Scott216/Poolduino/Board Files/Current_sensor.jpg

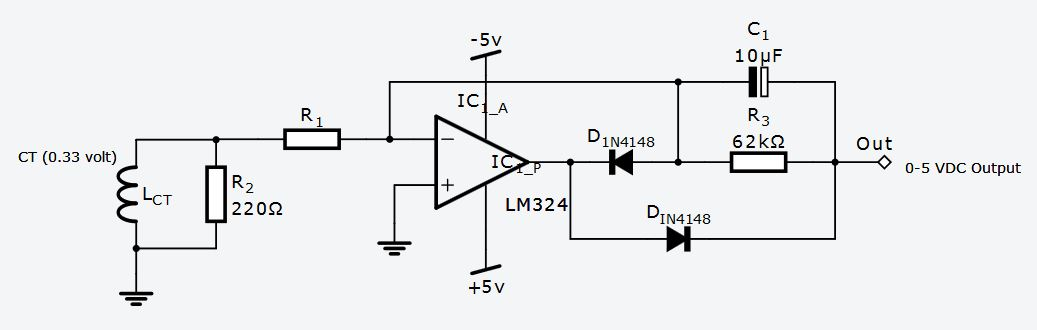
Board Files/Current_sensor.jpg
