Scott216/Poolduino/(threads)

Thread 2 (2015-03-03):

boards available

davecramer, 2015-03-03:
Sorry to use this forum for a question but it seems the only way

Have you produced boards ?

Scott216, 2015-03-05:
I made some PCB boards for myself, the files are located here:
https://github.com/Scott216/Poolduino/tree/master/Board%20Files

I don't have any plans to sell the PCB boards.

davecramer, 2015-03-05:
thx

Closed 2015-03-05.
