Scott216/Poolduino/Board Files/CT Amp.brd

## EAGLE design Board Files/CT Amp.brd (2016-04-02)

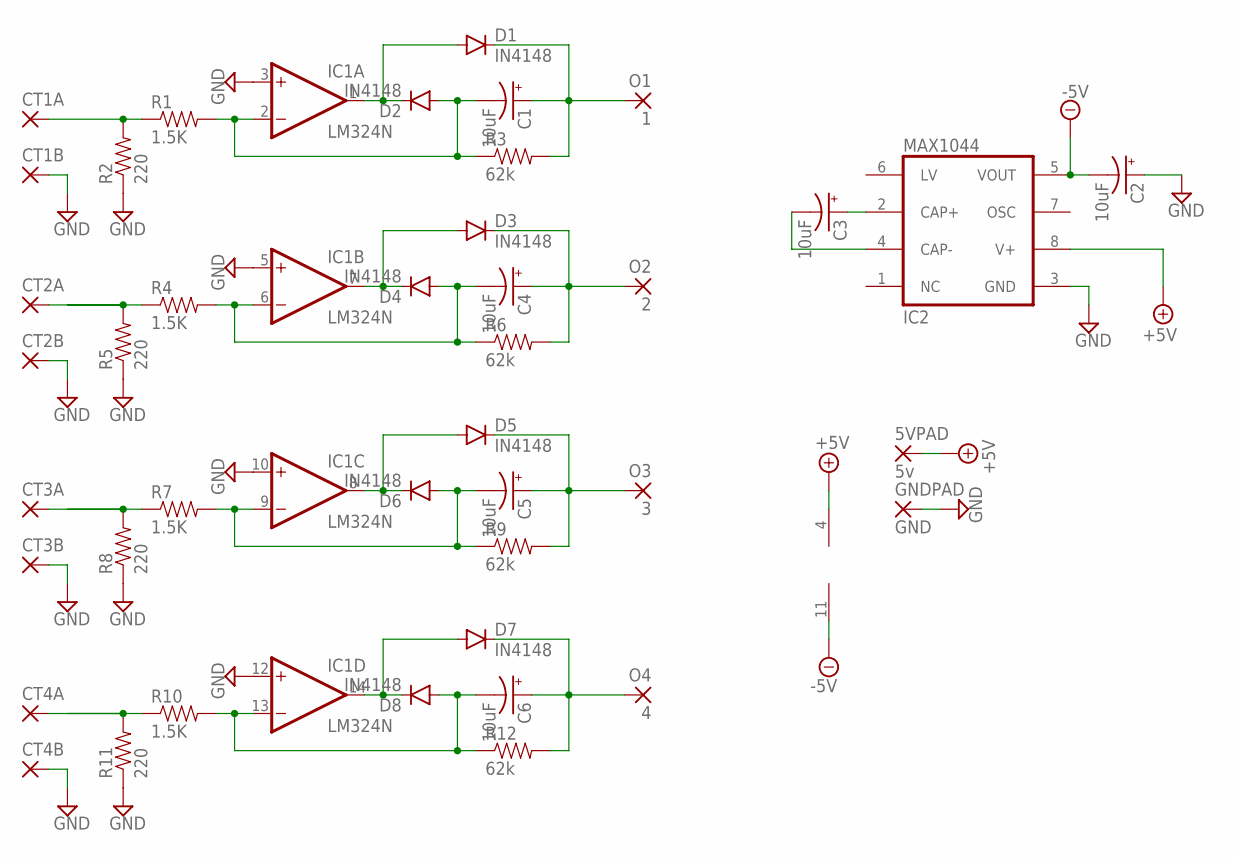
[picture p2: schematic CT Amp.sch]

Parts:
5VPAD: 5v; 2,54/1,0
C1, C2, C3, C4, C5, C6: 10uF; E2,5-6
CT1A, CT1B, CT2A, CT2B, CT3A, CT3B, CT4A, CT4B: 2,54/1,0
D1, D2, D3, D4, D5, D6, D7, D8: IN4148; DIODE-1N4001
GNDPAD: GND; 2,54/1,0
IC1: LM324N; DIL14
MAX1044: IC2; DIL08
O1: 1; 2,54/1,0
O2: 2; 2,54/1,0
O3: 3; 2,54/1,0
O4: 4; 2,54/1,0
R1, R4, R7, R10: 1.5K; AXIAL-0.4
R2, R5, R8, R11: 220; AXIAL-0.4
R3, R6, R9, R12: 62k; AXIAL-0.4

Connections:
+5V: 5VPAD.1, IC1.4 (V+), MAX1044.8 (V+)
-5V: C2.-, IC1.11 (V-), MAX1044.5 (VOUT)
GND: C2.+, CT1B.1, CT2B.1, CT3B.1, CT4B.1, GNDPAD.1, IC1.3 (+IN), IC1.5 (+IN), IC1.10 (+IN), IC1.12 (+IN), MAX1044.3 (GND), R2.P$1 (1), R5.P$1 (1), R8.P$1 (1), R11.P$1 (1)
unnamed: C3.+, MAX1044.2 (CAP+)
unnamed: C3.-, MAX1044.4 (CAP-)
unnamed: CT2A.1, R4.P$1 (1), R5.P$2 (2)
unnamed: C1.-, D2.A, IC1.2 (-IN), R1.P$2 (2), R3.P$1 (1)
unnamed: C5.-, D6.A, IC1.9 (-IN), R7.P$2 (2), R9.P$1 (1)
unnamed: CT3A.1, R7.P$1 (1), R8.P$2 (2)
unnamed: D1.A, D2.C, IC1.1 (OUT)
unnamed: D5.A, D6.C, IC1.8 (OUT)
unnamed: C5.+, D5.C, O3.1, R9.P$2 (2)
unnamed: C6.-, D8.A, IC1.13 (-IN), R10.P$2 (2), R12.P$1 (1)
unnamed: C4.-, D4.A, IC1.6 (-IN), R4.P$2 (2), R6.P$1 (1)
unnamed: D7.A, D8.C, IC1.14 (OUT)
unnamed: C6.+, D7.C, O4.1, R12.P$2 (2)
unnamed: C1.+, D1.C, O1.1, R3.P$2 (2)
unnamed: CT1A.1, R1.P$1 (1), R2.P$2 (2)
unnamed: CT4A.1, R10.P$1 (1), R11.P$2 (2)
unnamed: D3.A, D4.C, IC1.7 (OUT)
unnamed: C4.+, D3.C, O2.1, R6.P$2 (2)

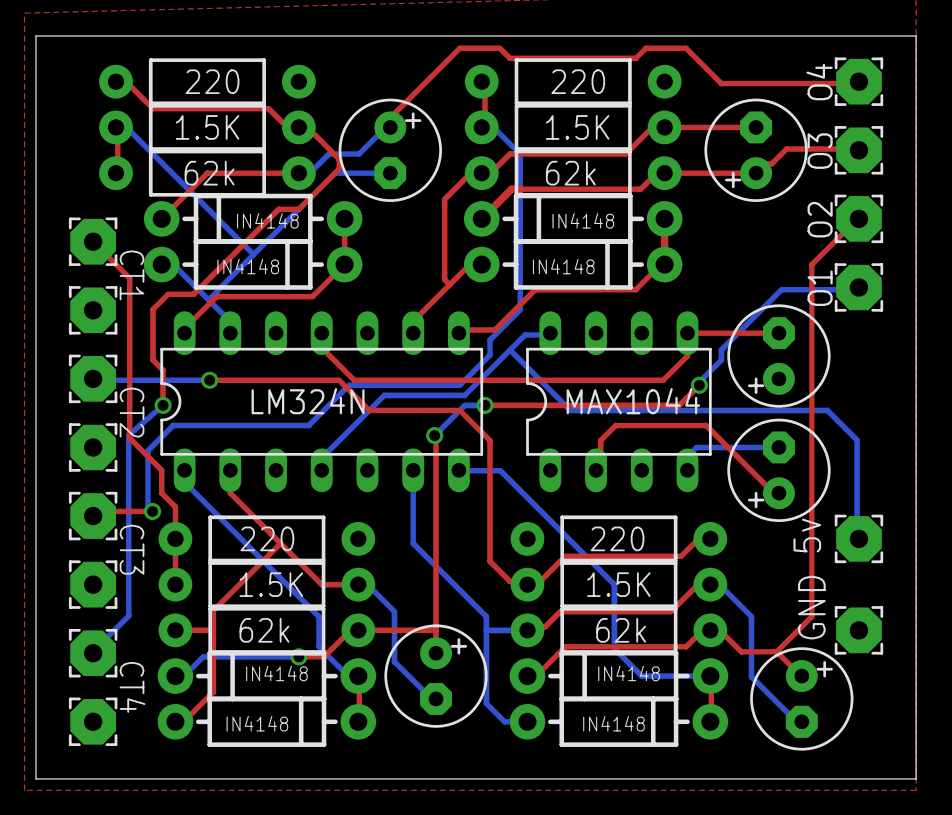
[picture p3: board CT Amp.brd from above]

Board: 2 copper layers, 48.9 x 41.3 mm, 42 parts (0 on the bottom side), 21 nets.
