Scott216/Poolduino/Board Files/Level Sensor v1.brd

## EAGLE design Board Files/Level Sensor v1.brd (2014-09-04)

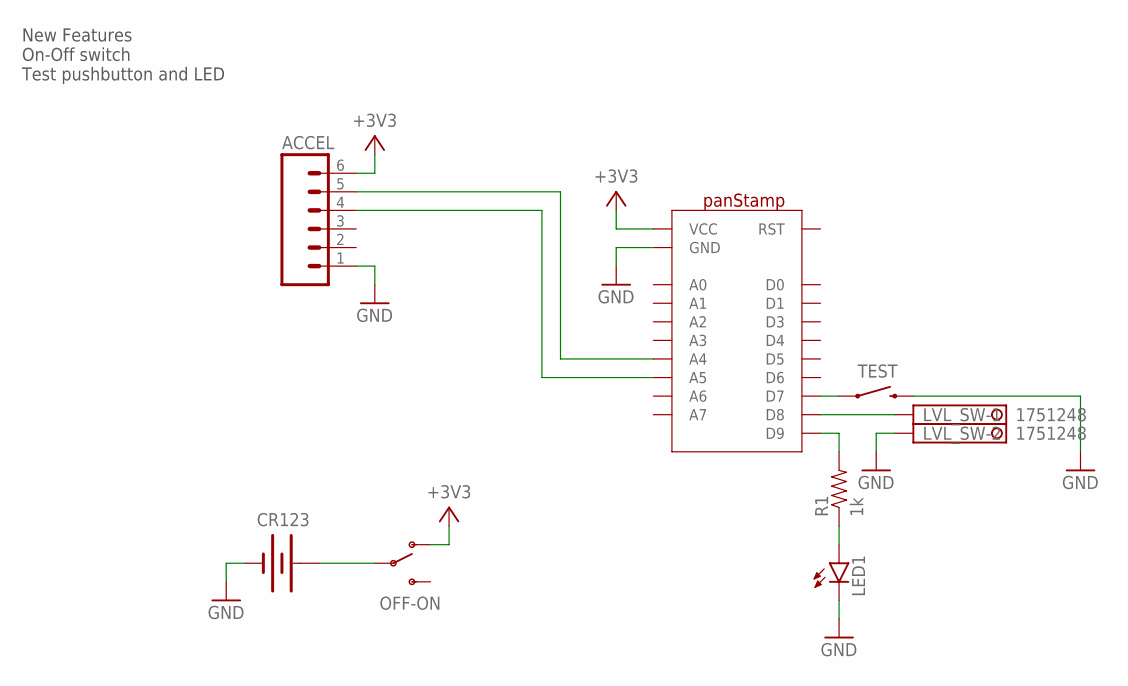
[picture p4: schematic Level Sensor v1.sch]

Parts:
ACCEL: M06LONGPADS; 1X06_LONGPADS
CR123: BATTERY_CR123_SINGLE; BATTERY_CR123
LED1: LED3MM
LVL_SW: 1751248
OFF-ON: SWITCH-SPDTPTH; SWITCH-SPDT
R1: 1k; AXIAL-0.4
TEST: SWITCH-MOMENTARY-2PTH; TACTILE-PTH
U$1: PANSTAMPWITH_TEXT; PANSTAMP

Connections:
+3V3: ACCEL.6, OFF-ON.1 (O), U$1.VCC
BAT+: CR123.POS (+), OFF-ON.2
GND: ACCEL.1, CR123.NEG (-), LED1.K (C), LVL_SW.2, TEST.3 (2), U$1.GND$1 (GND), U$1.GND$7 (GND), U$1.GND$15 (GND), U$1.GND$23 (GND), U$1.GND$24 (GND)
unnamed: LVL_SW.1, U$1.D8
unnamed: TEST.1, U$1.D7
unnamed: R1.P$2 (2), U$1.D9
unnamed: LED1.A, R1.P$1 (1)
SCL: ACCEL.4, U$1.A5
SDA: ACCEL.5, U$1.A4

Notes on the sheet:
New Features On-Off switch Test pushbutton and LED

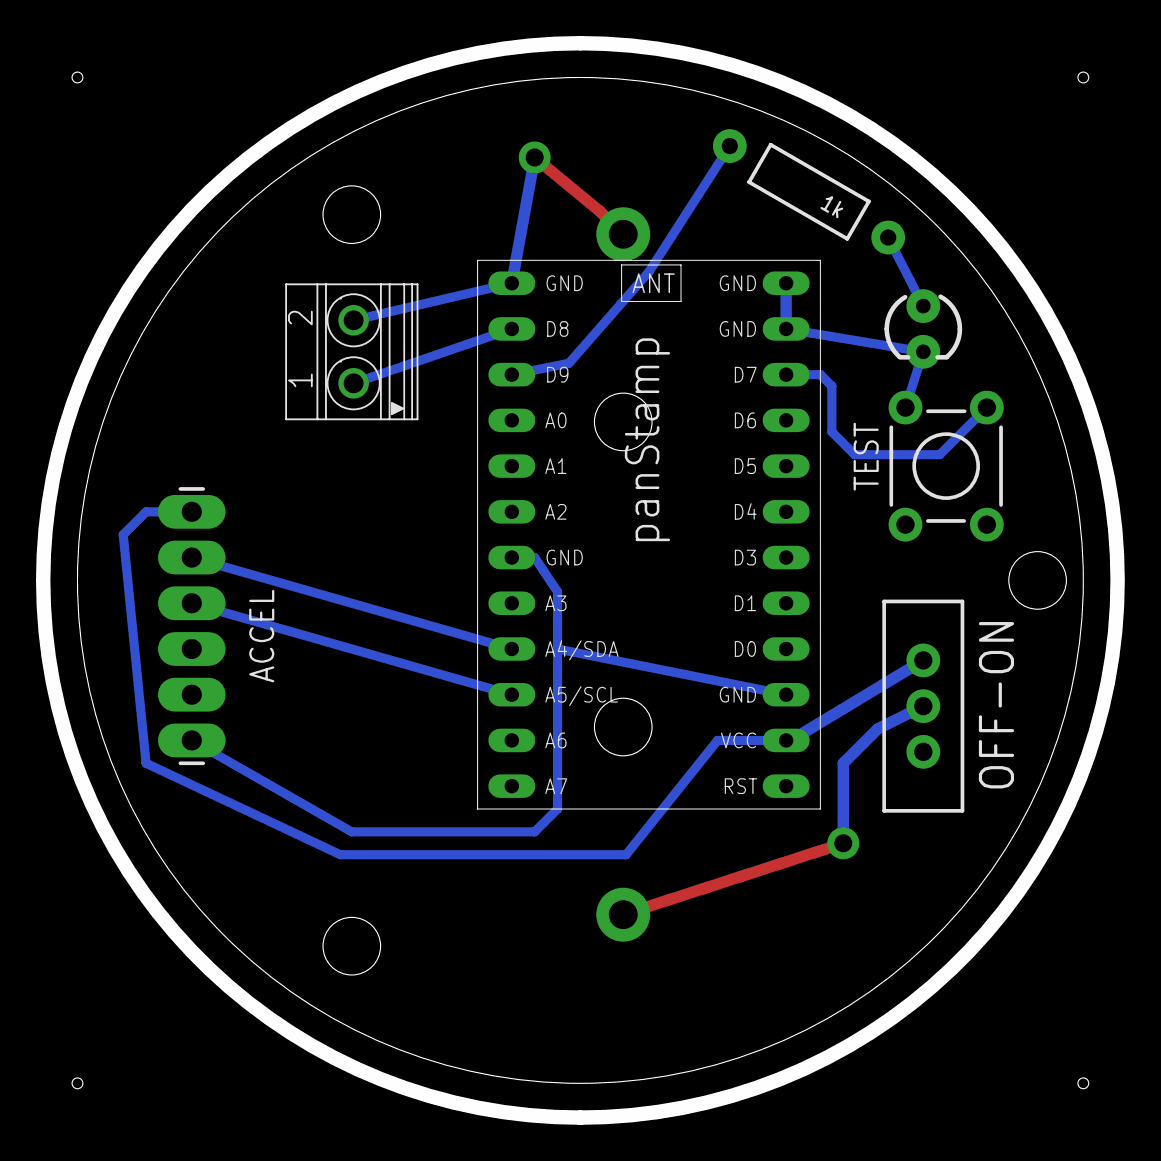
[picture p5: board Level Sensor v1.brd from above]

Board: 2 copper layers, 59.7 x 59.7 mm, 8 parts (1 on the bottom side), 9 nets.
