Scott216/Poolduino/Board Files/Xbee_Sheild_v2.brd

## EAGLE design Board Files/Xbee_Sheild_v2.brd (2014-09-04)

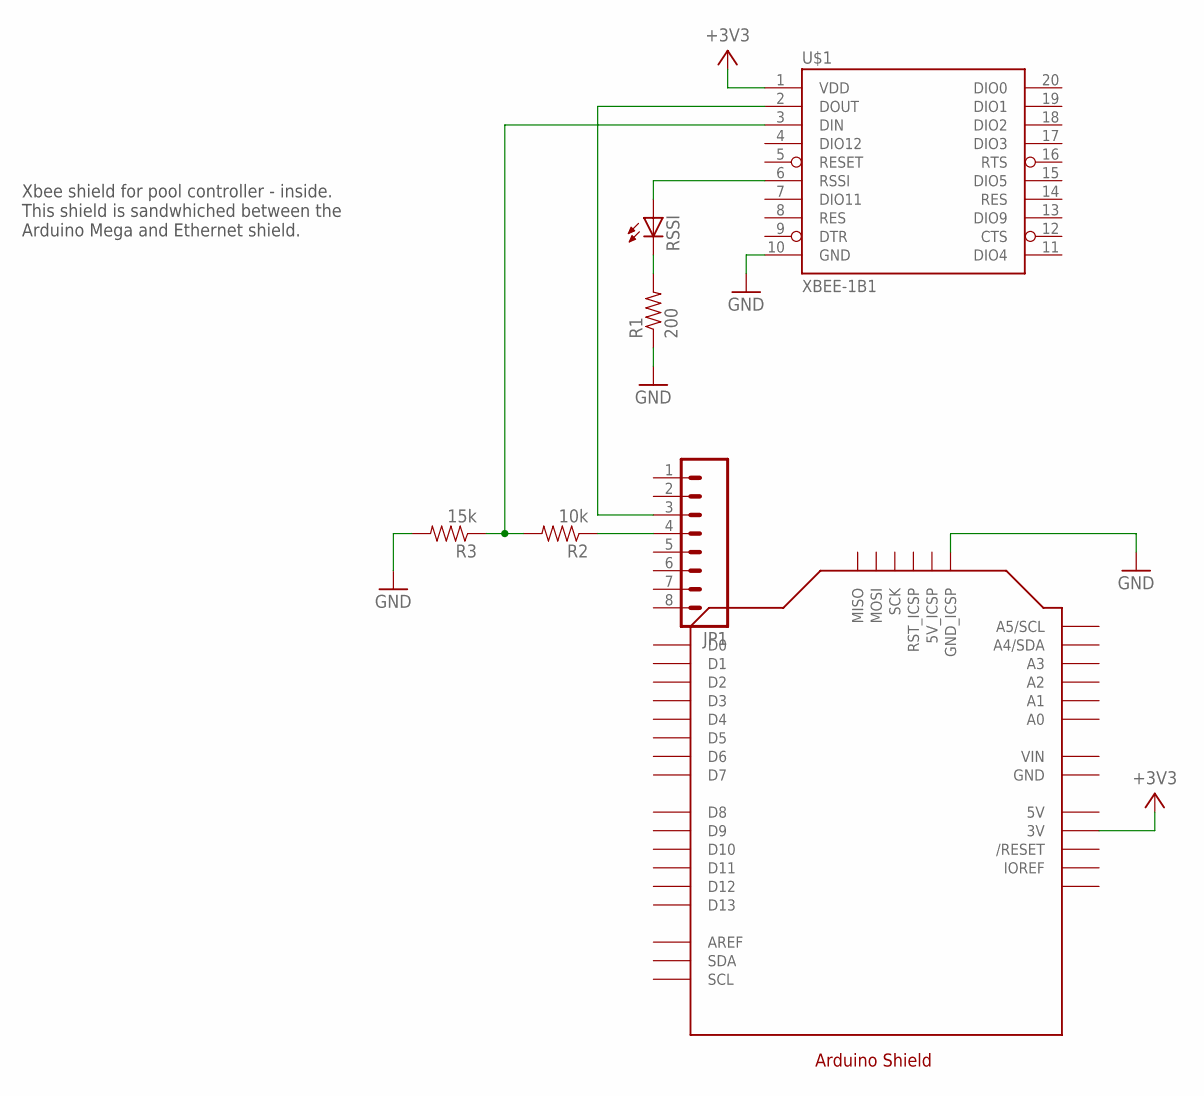
[picture p6: schematic Xbee_Sheild_v2.sch]

Parts:
JP1: M08LONGPADS; 1X08_LONGPADS
R1: 200; AXIAL-0.4
R2: 10k; AXIAL-0.4
R3: 15k; AXIAL-0.4
RSSI: LED5MM
U$1: XBEE-1B1; XBEE-1
U$2: ARDUINO_UNO_SHIELD_ICSP

Connections:
5V: U$2.5V@1 (5V)
5V_ICSP: U$2.5V_ICSP
+3V3: U$1.1 (VDD), U$2.3V
GND: R1.P$1 (1), R3.P$2 (2), U$1.10 (GND), U$2.GND@1 (GND), U$2.GND@2 (GND), U$2.GND@3 (GND), U$2.GND_ICSP
unnamed: JP1.3, U$1.2 (DOUT)
unnamed: JP1.4, R2.P$1 (1)
unnamed: RSSI.A, U$1.6 (RSSI)
unnamed: R1.P$2 (2), RSSI.K (C)
unnamed: R2.P$2 (2), R3.P$1 (1), U$1.3 (DIN)
VIN: U$2.VIN

Notes on the sheet:
Xbee shield for pool controller - inside. This shield is sandwhiched between the Arduino Mega and Ethernet shield.

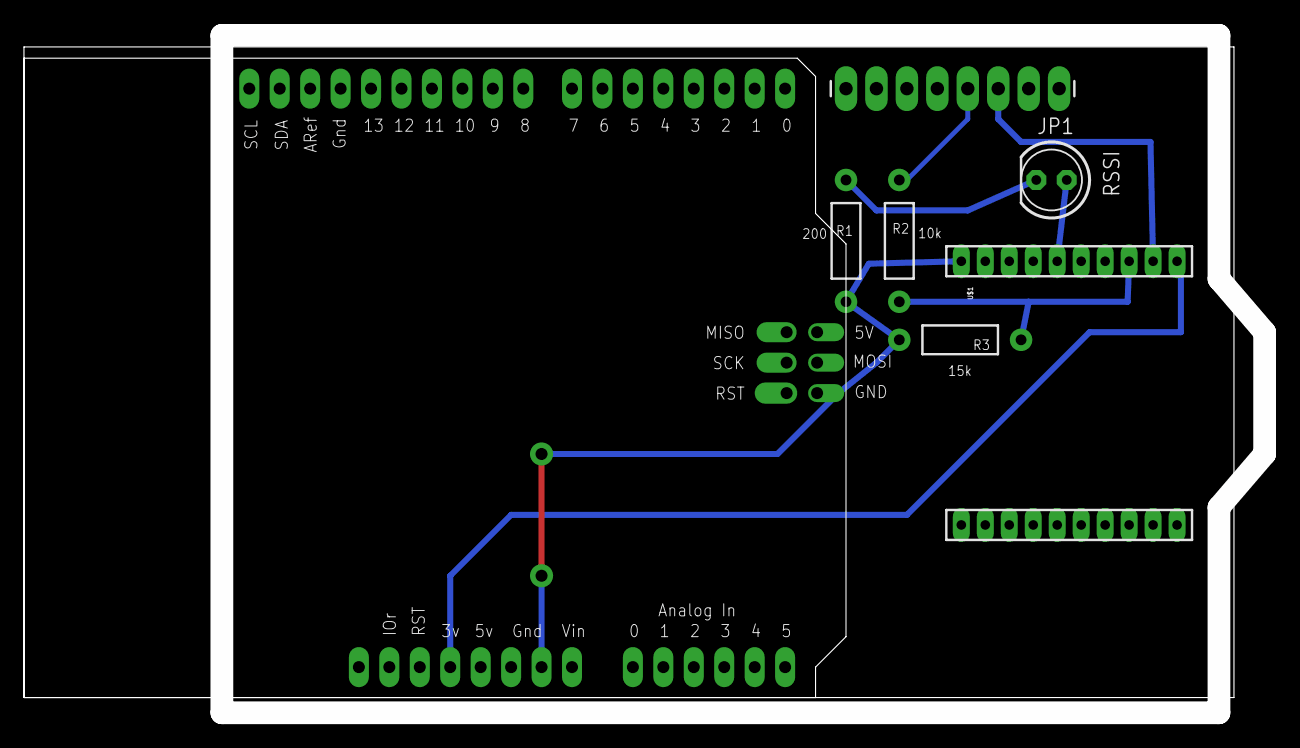
[picture p7: board Xbee_Sheild_v2.brd from above]

Board: 2 copper layers, 103.5 x 56.5 mm, 7 parts (0 on the bottom side), 7 nets.
