Scott216/Poolduino/Board Files/Outside Pool Controller v2.brd

## EAGLE design Board Files/Outside Pool Controller v2.brd (2014-09-04)

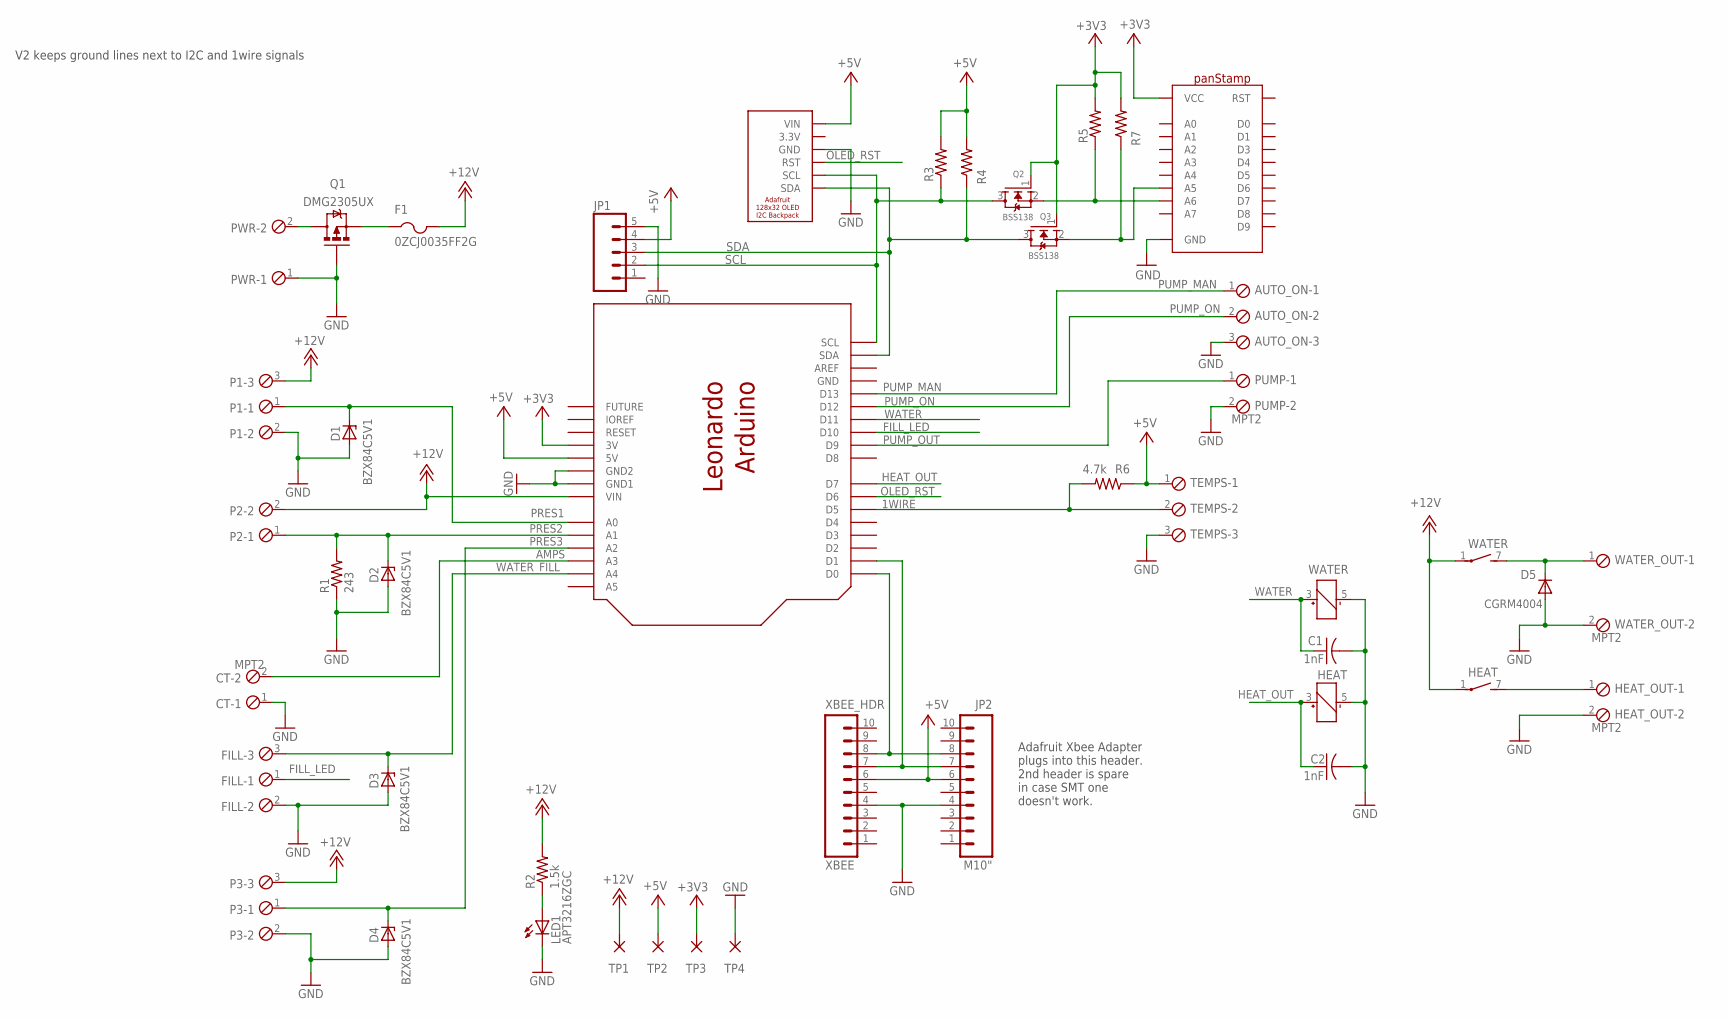
[picture p8: schematic Outside Pool Controller v2.sch]

Parts:
AUTO_ON: MPT3; 3POL254
C1, C2: 1nF; C1206
CT: MPT2; 2POL254
D1, D2, D3, D4: BZX84C5V1; SOT23
D5: CGRM4004; SOD-123FL
F1: 0ZCJ0035FF2G; R1206
FILL: MPT3; 3POL254
HEAT: REED
HEAT_OUT: MPT2; 2POL254
JP1: M05NO_SILK; 1X05_NO_SILK
JP2: M10"; 1X10
LED1: APT3216ZGC; CHIPLED_1206
P1, P3: MPT3; 3POL254
P2: MPT2; 2POL254
PUMP: MPT2; 2POL254
PWR: MPT2; 2POL254
Q1: DMG2305UX; SOT23-3
Q2, Q3: BSS138; SOT23
R1: 243; M1206
R2: 1.5k; M1206
R3, R4, R5, R7: R-US_M1206; M1206
R6: 4.7k; M1206
TEMPS: MPT3; 3POL254
TP1, TP2: 2,15/1,0
TP3, TP4: WIREPAD2,15/1,0; 2,15/1,0
U$1: ARDUINO_LEONARDO
U$2: ADAFRUIT_128X32_OLED; ADAFRUIT_OLED_128X32
U$3: PANSTAMPNO_TEXT; PANSTAMP_NOTEXT
WATER: REED
WATER_OUT: MPT2; 2POL254
XBEE_HDR: XBEE; 1X10_SMD_MALE

Connections:
1WIRE: R6.2, TEMPS.2, U$1.D5
3.3V: U$2.P$5 (3.3V)
+3V3: Q2.1 (G), Q3.1 (G), R5.2, R7.2, TP3.1, U$1.3V, U$3.VCC
+5V: JP1.4, JP2.6, R3.2, R4.2, R6.1, TEMPS.1, TP2.1, U$1.5V, U$2.P$6 (VIN), XBEE_HDR.6
+12V: F1.2, HEAT.1, P1.3, P2.2, P3.3, R2.2, TP1.1, U$1.VIN, WATER.1
AMPS: CT.2, U$1.A3
FILL_LED: FILL.1, U$1.D10
GND: AUTO_ON.3, C1.2, C2.2, CT.1, D1.1 (A), D2.1 (A), D3.1 (A), D4.1 (A), D5.A, FILL.2, HEAT.5 (-), HEAT_OUT.2, JP1.5, JP2.4, LED1.C, P1.2, P3.2, PUMP.2, PWR.1, Q1.1 (G), R1.1, TEMPS.3, TP4.1, U$1.GND, U$1.GND$2 (GND2), U$1.GND$3 (GND1), U$2.P$4 (GND), U$3.GND$1 (GND), U$3.GND$7 (GND), U$3.GND$15 (GND), U$3.GND$23 (GND), U$3.GND$24 (GND), WATER.5 (-), WATER_OUT.2, XBEE_HDR.4
HEAT_OUT: C2.1, HEAT.3 (+), U$1.D7
unnamed: D5.C, WATER.7 (S), WATER_OUT.1
unnamed: HEAT.7 (S), HEAT_OUT.1
unnamed: PWR.2, Q1.3 (D)
unnamed: LED1.A, R2.1
unnamed: F1.1, Q1.2 (S)
OLED_RST: U$1.D6, U$2.P$3 (RST)
PRES1: D1.3 (C), P1.1, U$1.A0
PRES2: D2.3 (C), P2.1, R1.2, U$1.A1
PRES3: D4.3 (C), P3.1, U$1.A2
PUMP_MAN: AUTO_ON.1, U$1.D13
PUMP_ON: AUTO_ON.2, U$1.D12
PUMP_OUT: PUMP.1, U$1.D9
SCL: JP1.2, Q2.3 (D), R3.1, U$1.SCL, U$2.P$2 (SCL)
SCL3.3: Q2.2 (S), R5.1, U$3.A6
SDA: JP1.3, Q3.3 (D), R4.1, U$1.SDA, U$2.P$1 (SDA)
SDA3.3: Q3.2 (S), R7.1, U$3.A5
WATER: C1.1, U$1.D11, WATER.3 (+)
WATER_FILL: D3.3 (C), FILL.3, U$1.A4
XBEE0: JP2.8, U$1.D0, XBEE_HDR.8
XBEE1: JP2.7, U$1.D1, XBEE_HDR.7

Notes on the sheet:
V2 keeps ground lines next to I2C and 1wire signals
Adafruit Xbee Adapter plugs into this header. 2nd header is spare in case SMT one doesn't work.

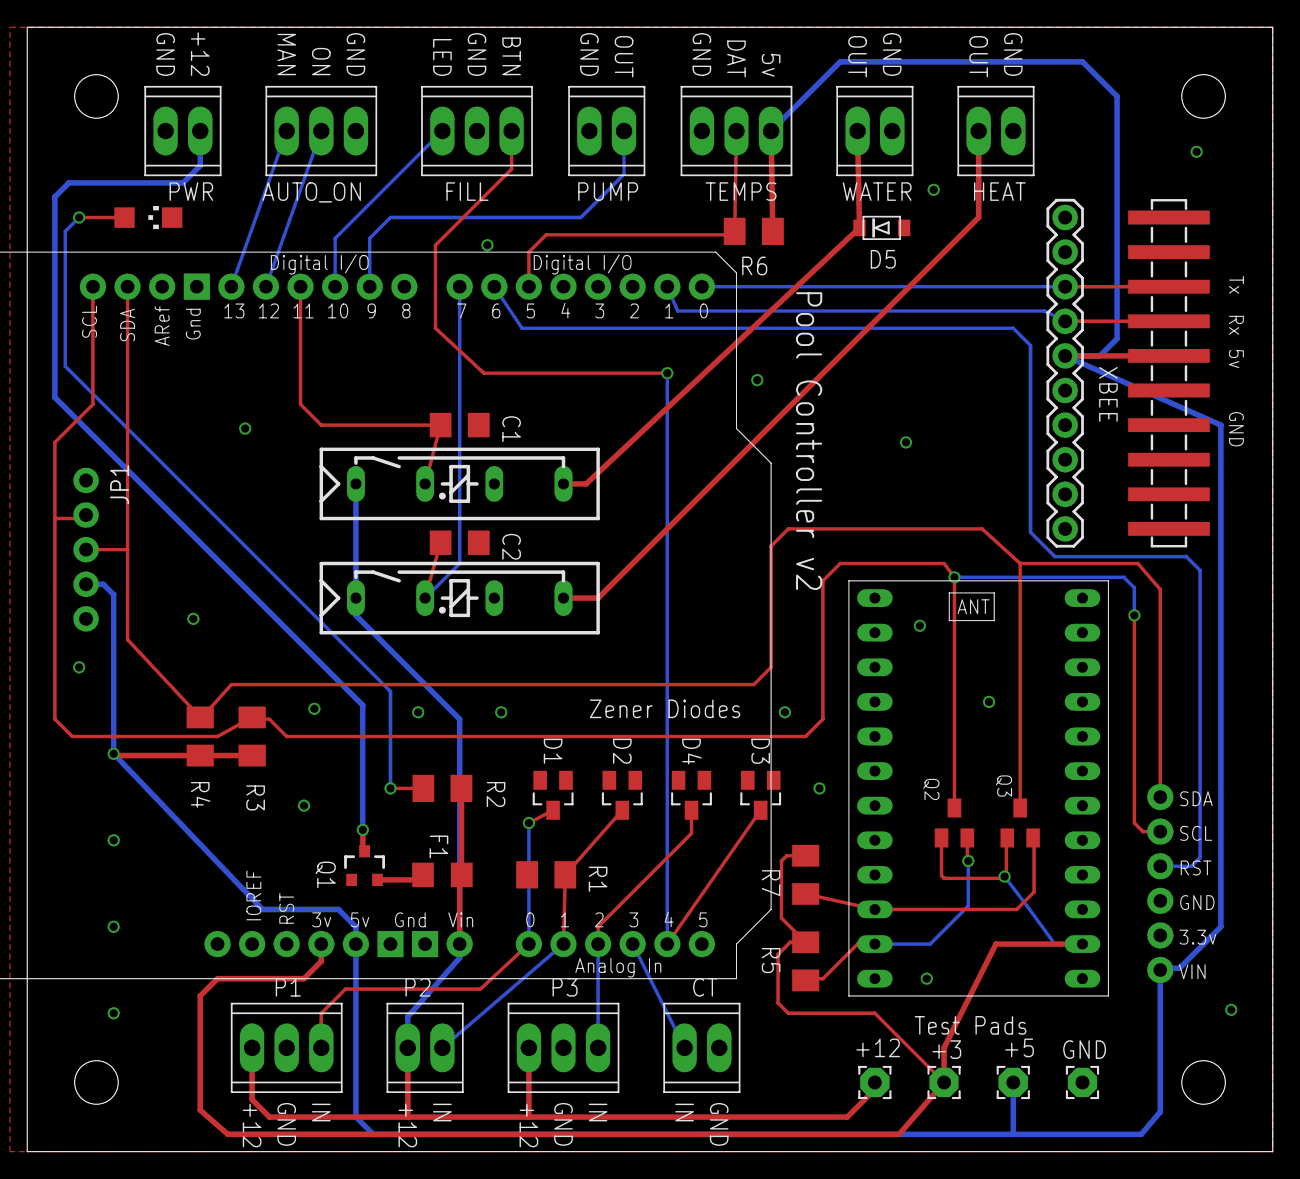
[picture p9: board Outside Pool Controller v2.brd from above]

Board: 2 copper layers, 91.4 x 82.5 mm, 42 parts (0 on the bottom side), 28 nets.
