Scott216/Poolduino/Pool_Controller_Outside/Pool_Controller_Outside/Pool_Controller_Outside_Library.cpp

//
// Pool_Controller_OutsideLibrary.cpp 
// Library C++ code
// ----------------------------------
// Developed with embedXcode+ 
// http://embedXcode.weebly.com
//
// Project 		Pool_Controller_Outside Library
//
// Created by 	Scott Goldthwaite, 1/24/14 3:09 PM
// 				Scott Goldthwaite
//
// Copyright 	© Scott Goldthwaite, 2014
// License		GNU General Public License
//
// See 			Pool_Controller_OutsideLibrary.cpp.h and ReadMe.txt for references
//


#include "Pool_Controller_Outside_Library.h"
