Scott216/Poolduino/Pool_Controller_Outside/Pool_Controller_Outside/Pool_Controller_Outside_Library.h

///
/// @mainpage	Pool_Controller_Outside Library
///
/// @details	Monitor and control swimming pool
/// @n			Library
/// @n
/// @n @a		Developed with [embedXcode+](http://embedXcode.weebly.com)
///
/// @author		Scott Goldthwaite
/// @author		Scott Goldthwaite
///
/// @date		1/24/14 3:09 PM
/// @version	<#version#>
///
/// @copyright	(c) Scott Goldthwaite, 2014
/// @copyright	GNU General Public License
///
/// @see		ReadMe.txt for references
///


///
/// @file		Pool_Controller_Outside_Library.h
/// @brief		Library header
/// Project 	Pool_Controller_Outside Library
///
/// @details	<#details#>
/// @n	
/// @n @b		Project Pool_Controller_Outside
/// @n @a		Developed with [embedXcode+](http://embedXcode.weebly.com)
/// 
/// @author		Scott Goldthwaite
/// @author		Scott Goldthwaite
///
/// @date		1/24/14 3:09 PM
/// @version	<#version#>
/// 
/// @copyright	(c) Scott Goldthwaite, 2014
/// @copyright	GNU General Public License
///
/// @see		ReadMe.txt for references
///



#ifndef Pool_Controller_Outside_RELEASE
#define Pool_Controller_Outside_RELEASE 100





#endif
