Scott216/Poolduino/Pool_Water_Level_Rx/Pool_Water_Level_Rx/Pool_Water_Level_Rx_Library.cpp

//
// Pool_Water_Level_RxLibrary.cpp 
// Library C++ code
// ----------------------------------
// Developed with embedXcode+ 
// http://embedXcode.weebly.com
//
// Project 		Pool_Water_Level_Rx Library
//
// Created by 	Scott Goldthwaite, 1/24/14 3:17 PM
// 				Scott Goldthwaite
//
// Copyright 	© Scott Goldthwaite, 2014
// License		GNU General Public License
//
// See 			Pool_Water_Level_RxLibrary.cpp.h and ReadMe.txt for references
//


#include "Pool_Water_Level_Rx_Library.h"
