Scott216/Poolduino/Pool_Water_Level_Rx/Pool_Water_Level_Rx/Pool_Water_Level_Rx_Library.h

///
/// @mainpage	Pool_Water_Level_Rx Library
///
/// @details	Receives water level status from Tx
/// @n			Library
/// @n
/// @n @a		Developed with [embedXcode+](http://embedXcode.weebly.com)
///
/// @author		Scott Goldthwaite
/// @author		Scott Goldthwaite
///
/// @date		1/24/14 3:17 PM
/// @version	<#version#>
///
/// @copyright	(c) Scott Goldthwaite, 2014
/// @copyright	GNU General Public License
///
/// @see		ReadMe.txt for references
///


///
/// @file		Pool_Water_Level_RxLibrary.h
/// @brief		Library header
/// Project 	Pool_Water_Level_Rx Library
///
/// @details	<#details#>
/// @n	
/// @n @b		Project Pool_Water_Level_Rx
/// @n @a		Developed with [embedXcode+](http://embedXcode.weebly.com)
/// 
/// @author		Scott Goldthwaite
/// @author		Scott Goldthwaite
///
/// @date		1/24/14 3:17 PM
/// @version	<#version#>
/// 
/// @copyright	(c) Scott Goldthwaite, 2014
/// @copyright	GNU General Public License
///
/// @see		ReadMe.txt for references
///


#ifndef Pool_Water_Level_Rx_RELEASE
#define Pool_Water_Level_Rx_RELEASE 100





#endif
