Scott216/Poolduino/Pool_Water_Level_Tx/Pool_Water_Level_Tx/Pool_Water_Level_Tx_Library.h

///
/// @mainpage	Pool_Water_Level_Tx Library
///
/// @details	Detects low water level and sends status to Rx
/// @n			Library
/// @n
/// @n @a		Developed with [embedXcode+](http://embedXcode.weebly.com)
///
/// @author		Scott Goldthwaite
/// @author		Scott Goldthwaite
///
/// @date		1/24/14 3:23 PM
/// @version	<#version#>
///
/// @copyright	(c) Scott Goldthwaite, 2014
/// @copyright	GNU General Public License
///
/// @see		ReadMe.txt for references
///


///
/// @file		Pool_Water_Level_TxLibrary.h
/// @brief		Library header
/// Project 	Pool_Water_Level_Tx Library
///
/// @details	<#details#>
/// @n	
/// @n @b		Project Pool_Water_Level_Tx
/// @n @a		Developed with [embedXcode+](http://embedXcode.weebly.com)
/// 
/// @author		Scott Goldthwaite
/// @author		Scott Goldthwaite
///
/// @date		1/24/14 3:23 PM
/// @version	<#version#>
/// 
/// @copyright	(c) Scott Goldthwaite, 2014
/// @copyright	GNU General Public License
///
/// @see		ReadMe.txt for references
///



#ifndef Pool_Water_Level_Tx_RELEASE
#define Pool_Water_Level_Tx_RELEASE 100


#endif
