Scott216/Poolduino/(commit log)

2013-08-01 added tweet for pump on at night
2013-08-21 rewrote how sensors are read. Added support for for 100 PSI sensor
2013-09-05 fixed bug in pressure cutoff and pump amps
    [Pool_Controller_Outside.ino]
2013-09-05 fixed bug in water fill pressure
    [Pool_Controller_Outside.ino]
2013-09-16 more data from water level sensor
2013-09-17 added alerts for heater on and sensor trouble
2014-06-04 Various
    Added alert for pump off in the day. Put array elements in enum().
    Changed xbee.begin(),
2014-06-23 v1.50. Fixed alerts
    Added missing resets to some of the twitter flags (tf_). Got rid of
    multiple alerts at 11PM. Added functions for sensor status. Don't
    upload streams to xively if sensor is bad or data is invalid.
    [Pool_Controller_Inside.ino, Pool_Controller_Inside_Library.h]
2014-06-24 v1.52 SD card
    If sensor isn't working, sent n/a to SD card instead of last known value
2014-06-26 delay in pump off
    Pump off delay to prevent false positive for current sensor status
    [Pool_Controller_Outside.ino]
2014-06-27 fixed overflow bug
    Fixed char overflow, removed pooltime from sendTweet() function. When
    alarm is triggered, record will be saved to SD card. Changed Xbee
    timeout from 5 min to 30 sec
    [Pool_Controller_Inside.ino]
2014-07-02 Fixed to work with new xbee library
    [Terminal Block Layout.xls]
2014-08-03 v1.58 - fixed false positive for alarm
    Put a delay in sending tweets. Alarm must still be active after 2
    seconds in order for tweet to be sent
    [Pool_Controller_Inside.ino]
2014-08-07 moved a couple variables around
    Removed a couple global variables
2014-08-07 v1.55 - changed water added minutes
    tracking of minutes of water added was in 15 minute chunks, now it’s 1
    minute chunks
2014-08-18 v1.59 Switched to Serial1 for Xbee, log lid is level
    Using Serial1 for Xbee. Logging if water level lid is level
2014-08-18 Switched water fill countdown with Is Lid Level
2014-08-18 Changed panstamp ok from 0 to 1
    Testing with water level sensor disconnected, about 10% of the time the
    sensor status byte said the level sensor was online. There are a lot
    of checksum errors on the I2C - all the data was zero except checksum.
    Zero is a valid value for the panstamp being online, so I changed it to
    a 1.
    [Pool_Controller_Inside.ino, Pool_Controller_Outside.ino, Pool_Water_Level_Rx.ino]
2014-09-03 Added pushbutton test and LED
2014-09-03 made constants upper case
2014-09-04 Initial Commit for Eagle files
    PCB files designed in Eagle 6.5
    [CT Amp.brd, CT Amp.sch, Level Sensor v1.brd, Level Sensor v1.sch, Outside Pool Controller v2.brd, Outside Pool Controller v2.sch, Xbee_Sheild_v2.brd, Xbee_Sheild_v2.sch]
2014-09-14 v1.61 - water fill alert, fixed bug in xbee data
    [Pool_Controller_Inside.ino]
2015-06-21 v1.63 OLED display, Low pressure
    Added code for OLED display, Reset low pressure alarm at midnight, code
    to detect pressure sensor failure
    [Pool_Controller_Outside.ino]
2015-07-10 v1.70 - fixed alert for water fill, changed time server
    [Pool_Controller_Inside.ino]
2015-07-12 v1.71 added Time_NTP.h library. 30 min delay to level sensor apart
2015-09-02 v1.64 - fixed low press alarm bug
    Also added #ifdef around OLED code to reduce program size
    [Pool_Controller_Outside.ino]
2015-09-02 v1.73 fixed xbee alert, adjusted EST time offset
    [Pool_Controller_Inside.ino]
2016-02-15 CT Amp schematic
2016-04-02 v2 - Rerouted PCB
    Original board had some problems, so I rerouted the traces
    [CT Amp.brd, CT Amp.sch]
2016-06-18 v1.65 prints time in setup()
2016-06-18 v1.74 - undid v1.73. Was causing reboots
    [Pool_Controller_Inside.ino]
